ane109/nRF52830-Dongle_Charger_Prototype/README.md

# nRF52830-Dongle_Charger_Prototype
Li-Ion test circuitry for an nRF52830-Dongle board

## Details
- Supplies battery power to nRF52840-Dongle when USB power is unavailable.
- Physical disconnect switch for battery.
- I2C Coulumb counter to monitor charge state
- 1.8V Voltage regulator for future ICs

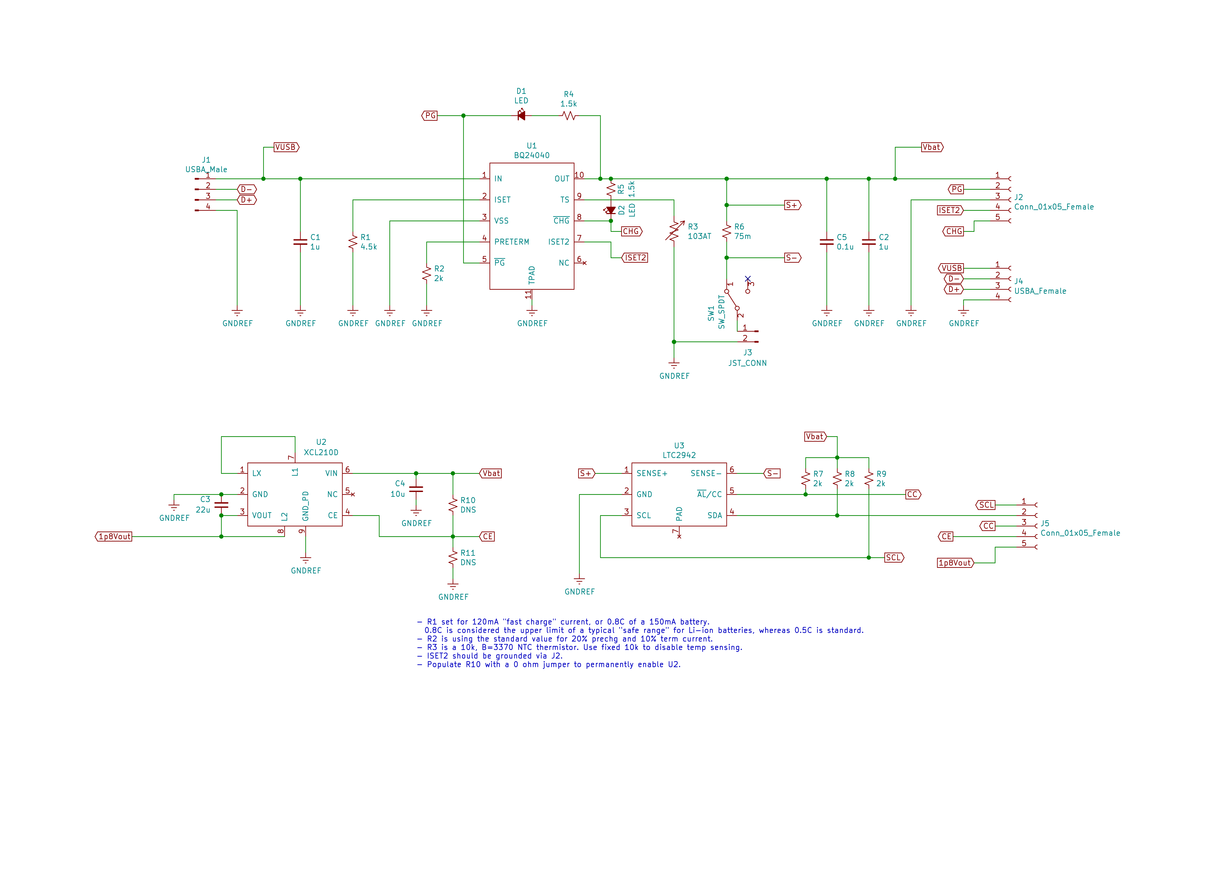
[picture p1: Media/Schematic_full.png]
Schematic


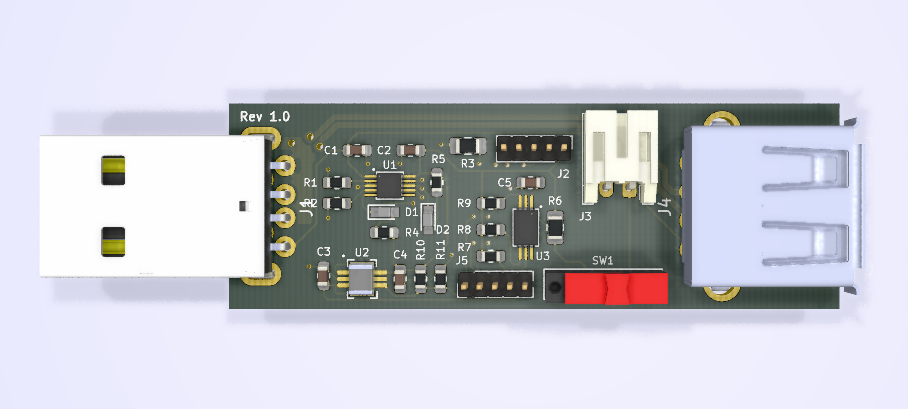
[picture p2: Media/3d_view.png]
3d view of board


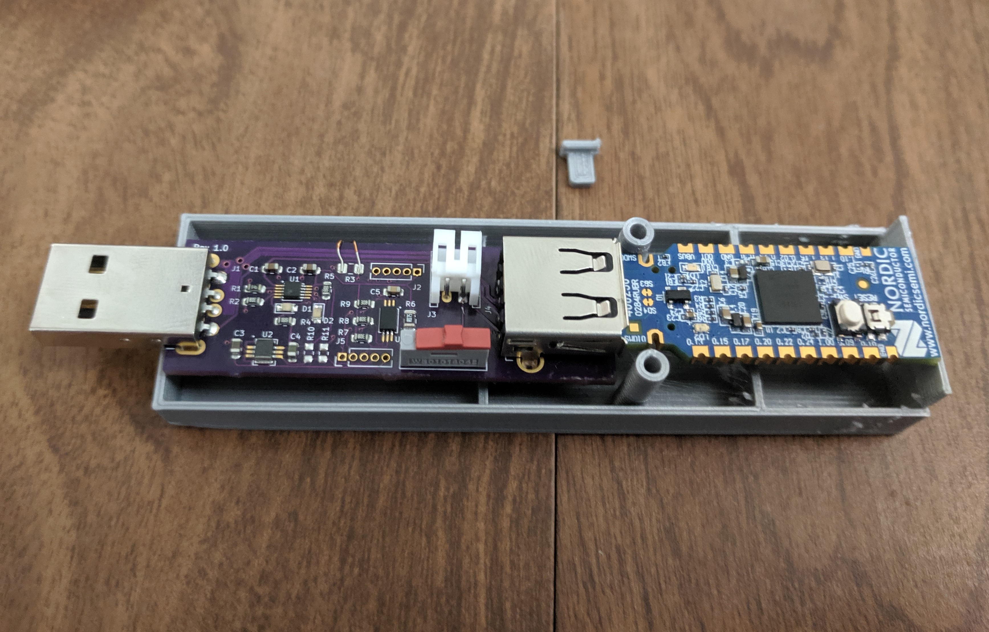
[picture p3: Media/Charger_Dongle_Assy.jpg]
Assembled unit with nRF52840 in a 3d printed case
