ane109/nRF52830-Dongle_Charger_Prototype/Enclosure_Design_Files/Charger Assy v3p1.FCStd

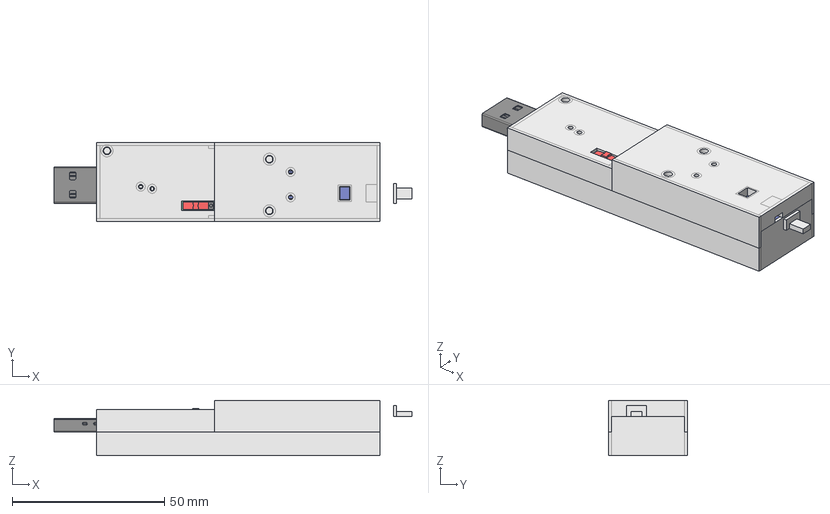
[picture p4: CAD file, 2025-05-28]
Enclosure_Design_Files/Charger Assy v3p1.FCStd
117.8 x 26.0 x 18.2 mm
Pcb
J1_CUI_UP2-AH-1-TH_5D158044
D2_SMLD1_5D264417
D1_SMLD1_5D264249
U2_XCL220B153FR-G--3DModel-STEP-56544_5D263DE4
U1_DSQ10_P9X1P5_5D263E8E
U3_DFN-6_DCB_5D264076
C5_C_0603_1608Metric_5D2642DD
C3_C_0603_1608Metric_5D2642AD
C1_C_0603_1608Metric_5D26435B
C2_C_0603_1608Metric_5D26444B
C4_C_0603_1608Metric_5D26427D
J3_JST_S2B_PH_K_5D2653B7
R1_R_0603_1608Metric_5D2644F9
R2_R_0603_1608Metric_5D2644C9
R3_R_0805_2012Metric_5D263EEA
R4_R_0603_1608Metric_5D26403A
R5_R_0603_1608Metric_5D263E48
R6_R_0805_2012Metric_5D263FDA
R7_R_0603_1608Metric_5D26400A
R8_R_0603_1608Metric_5D263FAA
R9_R_0603_1608Metric_5D263F7A
R10_R_0603_1608Metric_5D263F1A
R11_R_0603_1608Metric_5D263F4A
M_UE27_AC54_100_REVG1
cover
slide
nRF Dongle
Battery
TopShellFront
ResetButton
TopShellBack
BottomShell
