ane109/nRF52830-Dongle_Charger_Prototype/Enclosure_Design_Files/Charger Assy v3p1-TopShellBack.stl

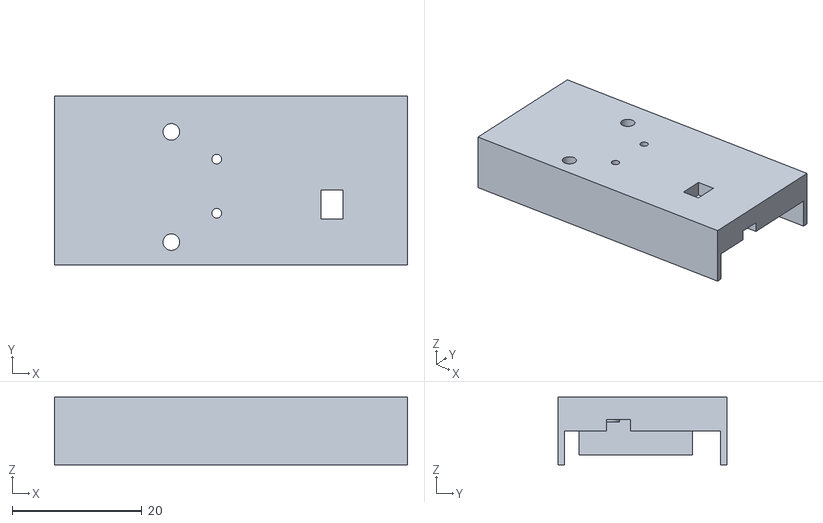
[picture p5: CAD file, 2025-05-28]
Enclosure_Design_Files/Charger Assy v3p1-TopShellBack.stl
54.4 x 26.0 x 10.5
