ane109/nRF52830-Dongle_Charger_Prototype/Enclosure_Design_Files/Charger Assy v3p1-TopShellFront.stl

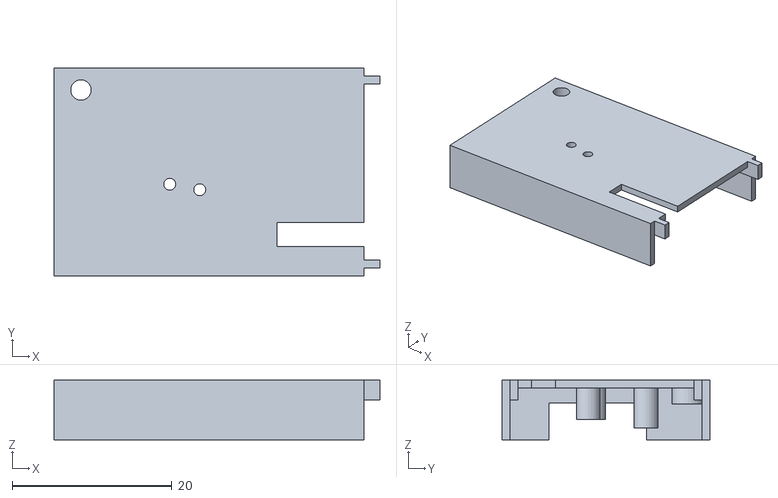
[picture p6: CAD file, 2025-05-28]
Enclosure_Design_Files/Charger Assy v3p1-TopShellFront.stl
40.7 x 26.0 x 7.45
