ane109/nRF52830-Dongle_Charger_Prototype/Enclosure_Design_Files/Charger Assy v3p1-ResetButton.stl

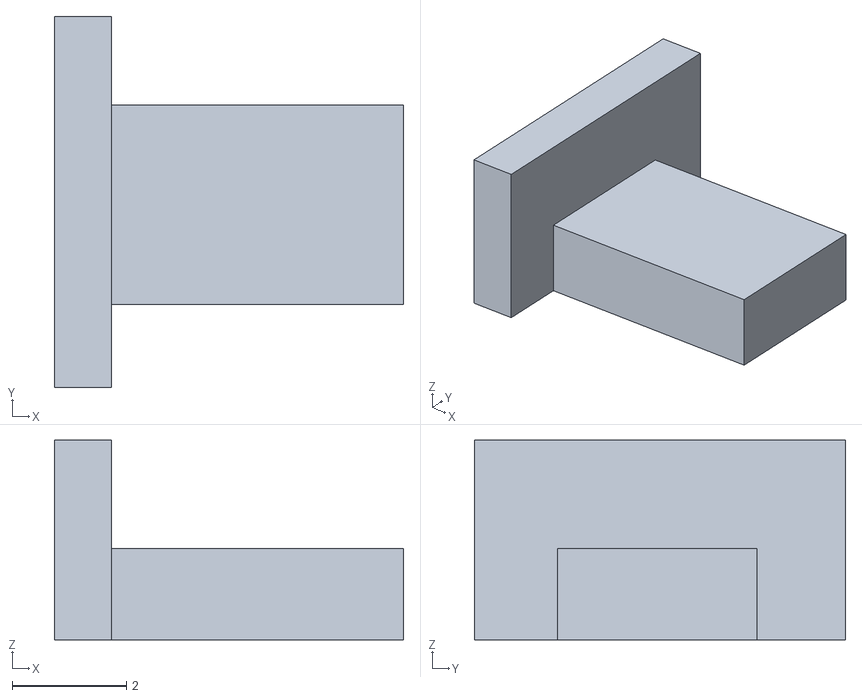
[picture p7: CAD file, 2025-05-28]
Enclosure_Design_Files/Charger Assy v3p1-ResetButton.stl
6.12 x 6.50 x 3.50
