ane109/nRF52830-Dongle_Charger_Prototype/Enclosure_Design_Files/Charger Assy v3p1-BottomShell.stl

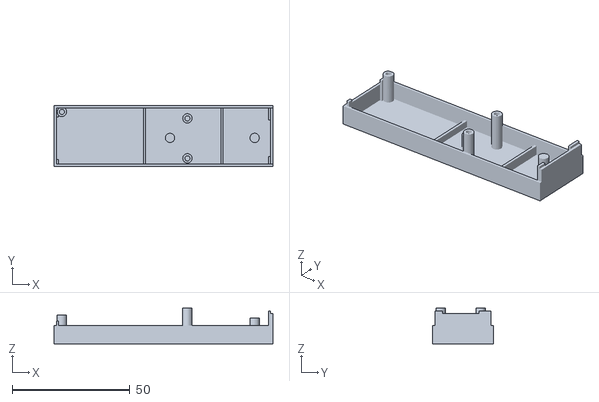
[picture p8: CAD file, 2025-05-28]
Enclosure_Design_Files/Charger Assy v3p1-BottomShell.stl
93.2 x 26.0 x 15.2
