ane109/nRF52830-Dongle_Charger_Prototype/Charger Prototype.kicad_pcb

## KiCad design Charger Prototype.kicad_pcb (2025-05-27)

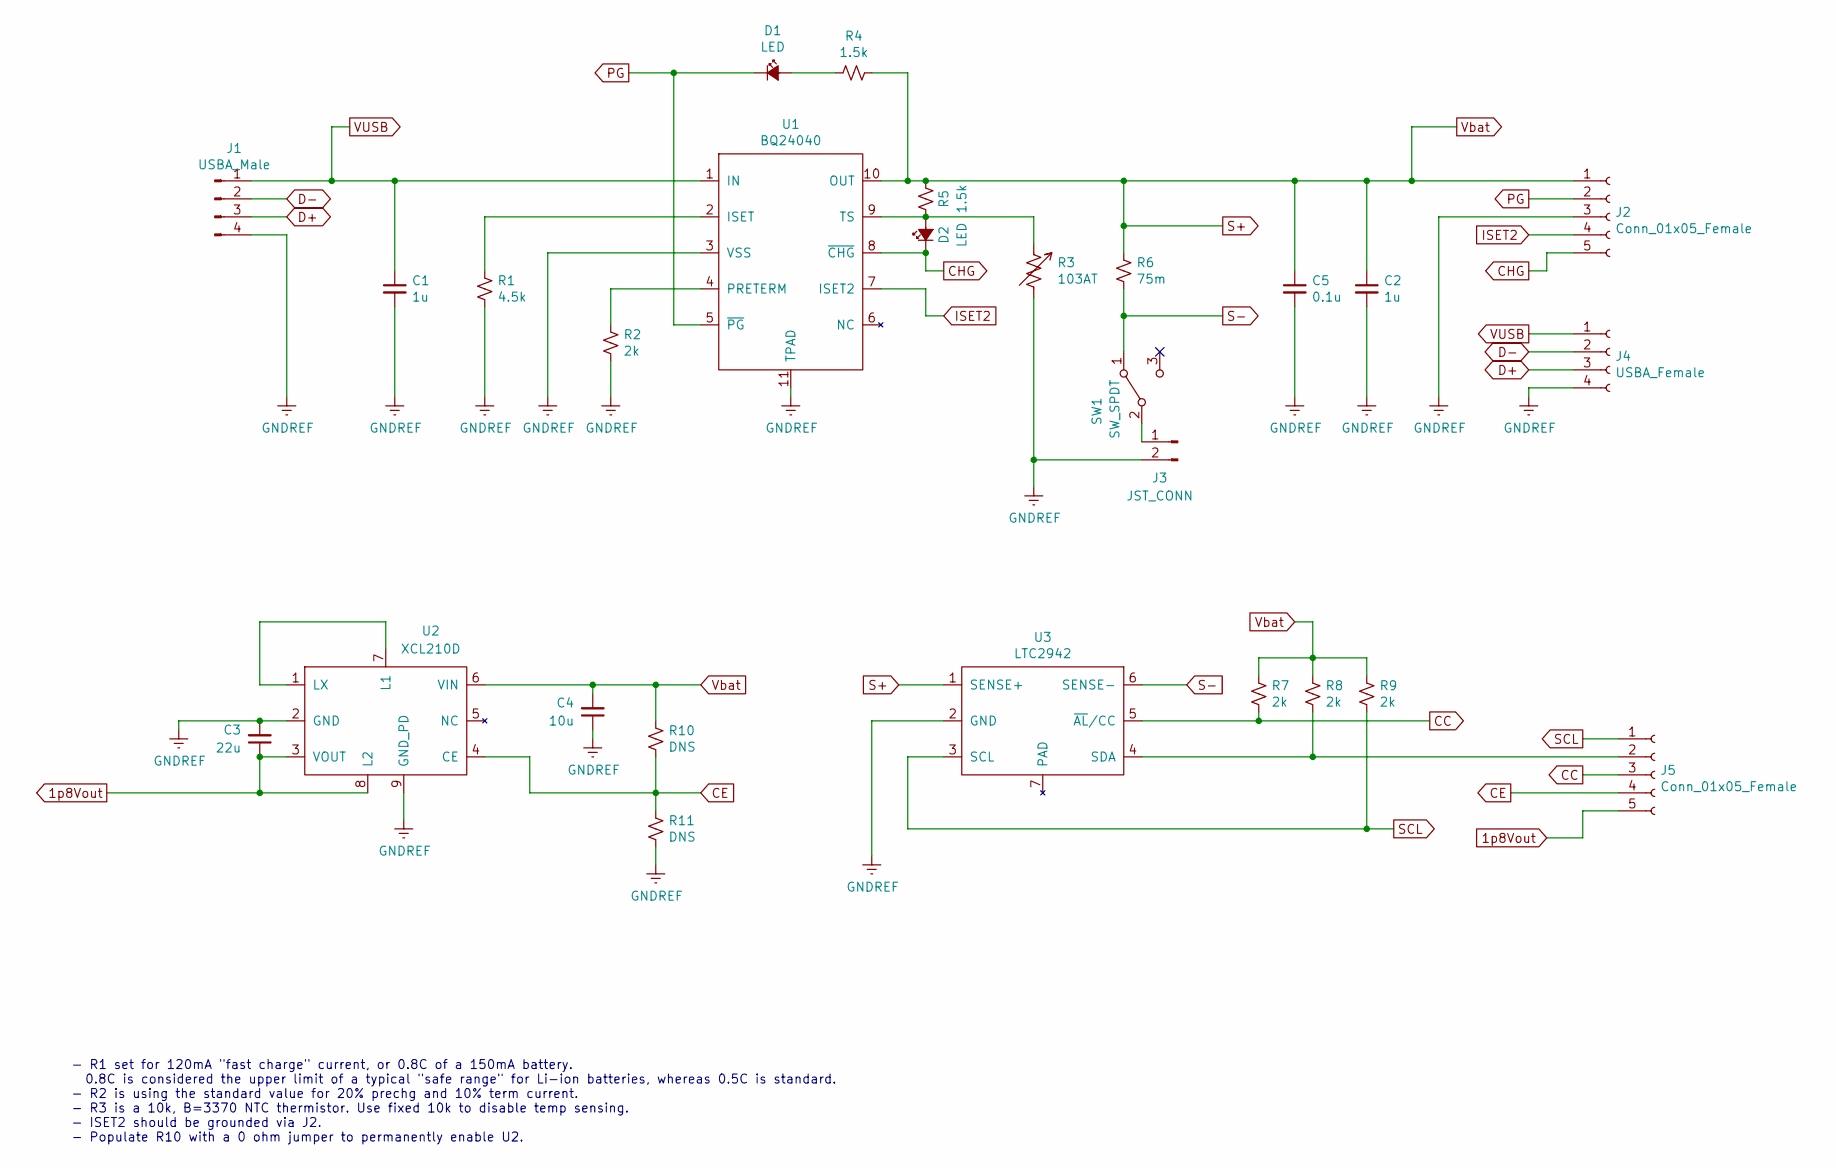
[picture p9: schematic Charger Prototype.kicad_sch, Power Subsystem Prototype]

Parts:
C1, C2: 1u; C_0603_1608Metric
C3: 22u; C_0603_1608Metric
C4: 10u; C_0603_1608Metric
C5: 0.1u; C_0603_1608Metric
D1, D2: LED; SML-D12
J1: USBA_Male; USB_Male_A_UP2-AH-1-TH_3d
J2, J5: Conn_01x05_Female; PinHeader_1x05_P1.27mm_Vertical
J3: JST_CONN; JST_PH_S2B-PH-K_1x02_P2.00mm_Horizontal
J4: USBA_Female; USB_A_Female_UE27AC54100_3d
R1: 4.5k; R_0603_1608Metric
R2, R7, R8, R9: 2k; R_0603_1608Metric
R3: 103AT; R_0805_2012Metric_Pad1.15x1.40mm_HandSolder
R4, R5: 1.5k; R_0603_1608Metric
R6: 75m; R_0805_2012Metric
R10, R11: DNS; R_0603_1608Metric
SW1: SW_SPDT; Wurth_SPDT_Slide_450301014042
U1: BQ24040; BQ24040_10mil
U2: XCL210D; XCL210_10mil
U3: LTC2942

Connections:
1p8Vout: C3.1, J5.5, U2.3 (VOUT), U2.8 (L2)
CC: J5.3, R7.2, U3.5 (~AL/CC)
CE: J5.4, R10.2, R11.1, U2.4 (CE)
CHG: D2.1 (K), J2.5, U1.8 (~CHG)
D+: J1.3, J4.3
D-: J1.2, J4.2
GNDREF: C1.2, C2.2, C3.2, C4.1, C5.2, J1.4, J2.3, J3.2, J4.4, R1.2, R2.2, R3.2, R11.2, U1.3 (VSS), U1.11 (TPAD), U2.2 (GND), U2.9 (GND_PD), U3.2 (GND)
ISET2: J2.4, U1.7 (ISET2)
unnamed: D1.2 (A), R4.2
unnamed: J3.1, SW1.2 (B)
unnamed: J5.2, R8.2, U3.4 (SDA)
unnamed: R1.1, U1.2 (ISET)
unnamed: R2.1, U1.4 (PRETERM)
unnamed: U2.1 (LX), U2.7 (L1)
PG: D1.1 (K), J2.2, U1.5 (~PG)
S+: C2.1, C4.2, C5.1, J2.1, R4.1, R5.2, R6.1, R7.1, R8.1, R9.1, R10.1, U1.10 (OUT), U2.6 (VIN), U3.1 (SENSE+)
S-: R6.2, SW1.1 (A), U3.6 (SENSE-)
SCL: J5.1, R9.2, U3.3 (SCL)
VUSB: C1.1, J1.1, J4.1, U1.1 (IN)

Notes on the sheet:
- R1 set for 120mA "fast charge" current, or 0.8C of a 150mA battery. 0.8C is considered the upper limit of a typical "safe range" for Li-ion batteries, whereas 0.5C is standard. - R2 is using the standard value for 20% prechg and 10% term current. - R3 is a 10k, B=3370 NTC thermistor. Use fixed 10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
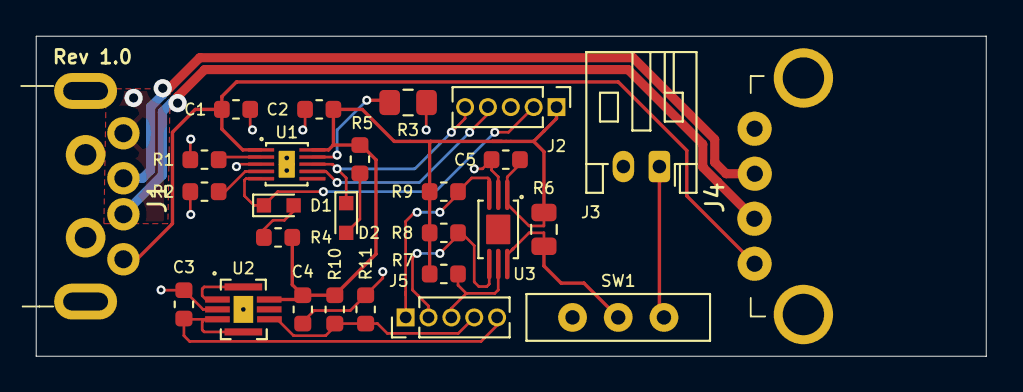
[picture p10: board Charger Prototype.kicad_pcb from above]

Board: 2 copper layers, 52.8 x 17.8 mm, 27 parts (0 on the bottom side), 21 nets.
