ane109/nRF52830-Dongle_Charger_Prototype/(commit log)

2025-05-28 Added files
    Design notes and images added. STLs for 3d-printable enclosure added.
    [Charger Assy v3p1-BottomShell.stl, Charger Assy v3p1-ResetButton.stl, Charger Assy v3p1-TopShellBack.stl, Charger Assy v3p1-TopShellFront.stl, Charger Assy v3p1.FCStd]
2025-06-23 Rename Printing Print Schematic_full.png to Schematic_full.png
2025-06-23 Moved Charger_Dongle_Assy.jpg to Media/Charger_Dongle_Assy.jpg
2025-06-23 Moved Schematic_full.png to Media/Schematic_full.png
2025-06-23 Update README.md
    Added schematic and images
